yohandev/ezbot/src/assets/info/enclosure.png

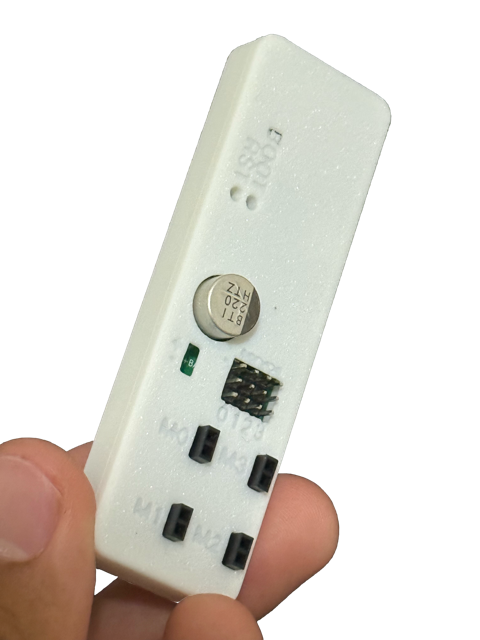
src/assets/info/enclosure.png
