yohandev/ezbot/src/assets/info/servo_motor.png

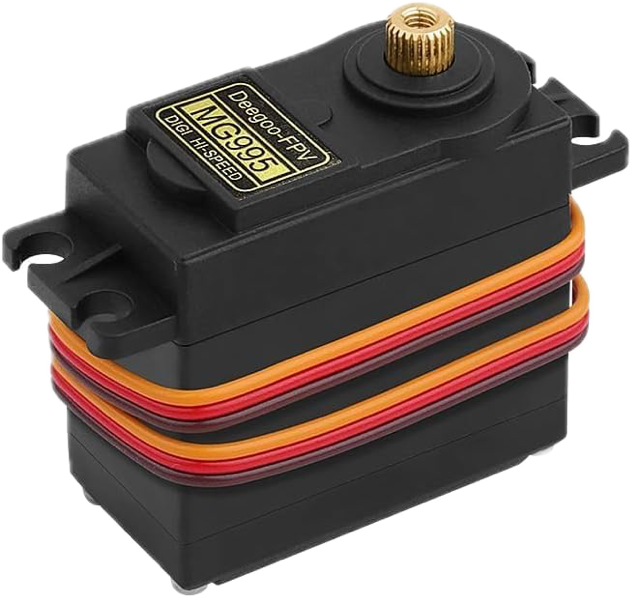
src/assets/info/servo_motor.png
