yohandev/ezbot/src/assets/bluefy.webp

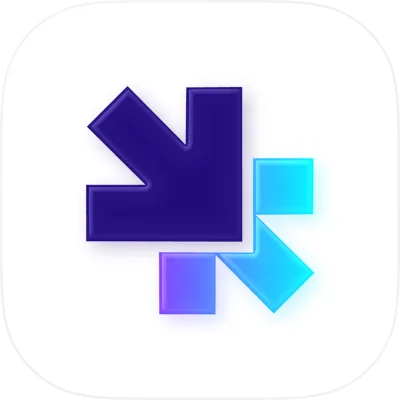
src/assets/bluefy.webp
