yohandev/ezbot/src/assets/info/battery.png

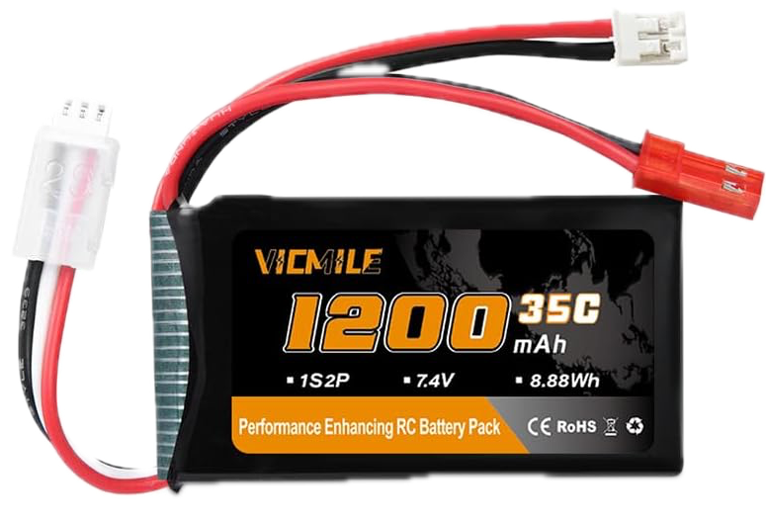
src/assets/info/battery.png
