yohandev/ezbot/src/assets/info/dc_motor.png

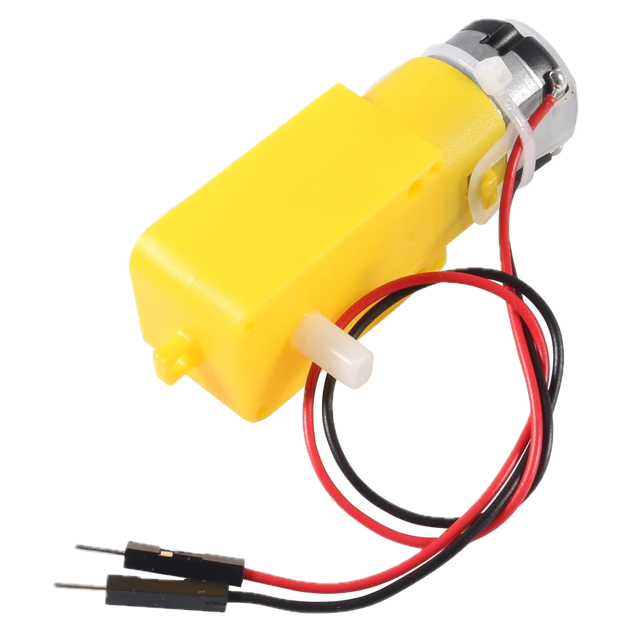
src/assets/info/dc_motor.png
