yohandev/ezbot/src/assets/demo-robot/chassis.3mf

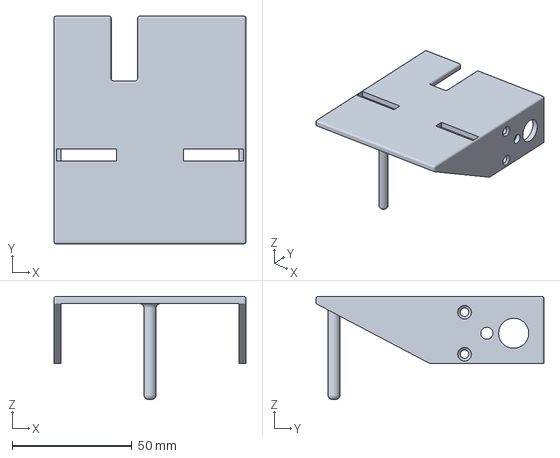
[picture p6: CAD file, 2026-04-05]
src/assets/demo-robot/chassis.3mf
80.0 x 95.0 x 43.0 mm
