yohandev/ezbot/src/assets/enclosure/lid.3mf

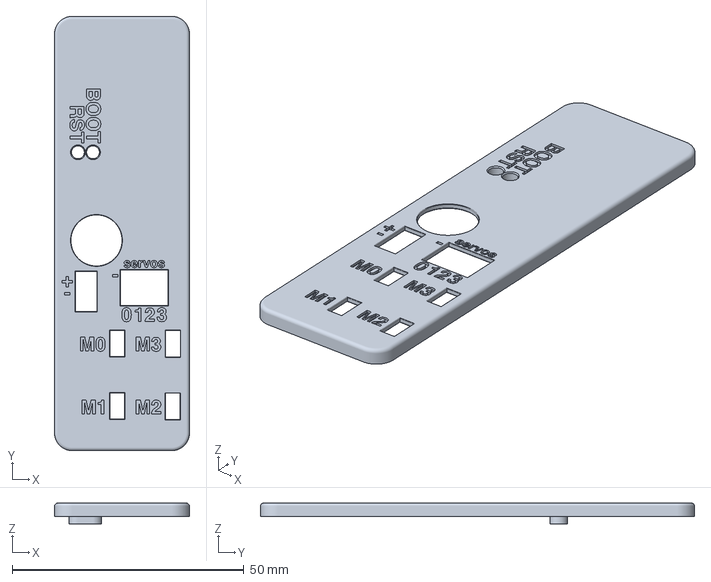
[picture p7: CAD file, 2026-04-09]
src/assets/enclosure/lid.3mf
29.1 x 93.6 x 4.50 mm
