yohandev/ezbot/src/assets/demo-robot/wheel.3mf

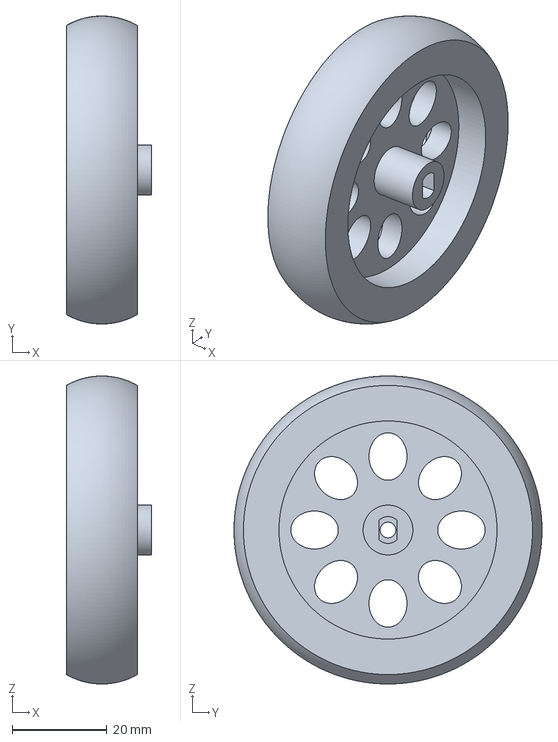
[picture p8: CAD file, 2026-04-05]
src/assets/demo-robot/wheel.3mf
18.0 x 65.0 x 65.0 mm
