yohandev/ezbot/src/assets/enclosure/body.3mf

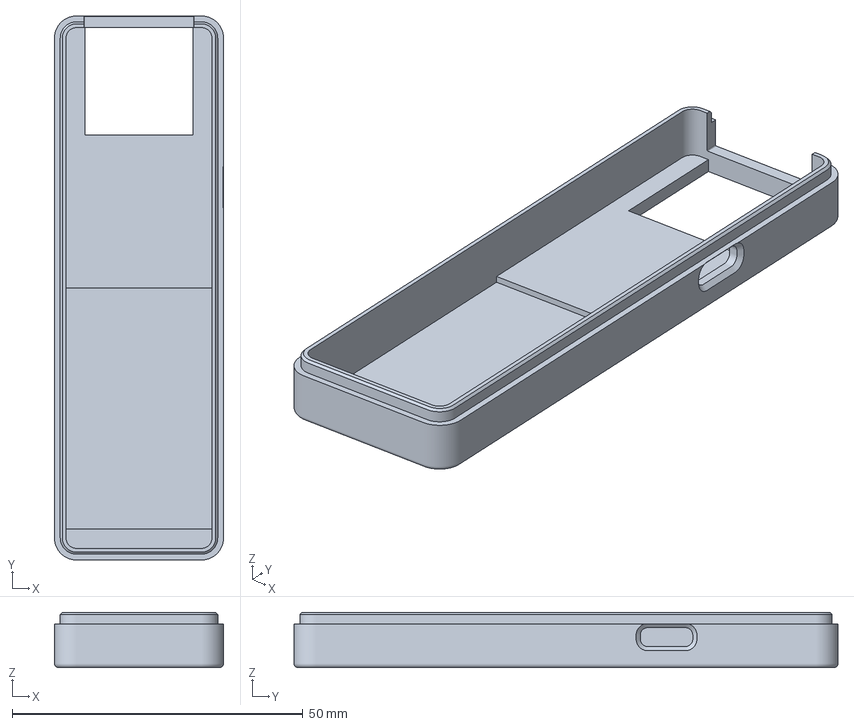
[picture p9: CAD file, 2026-04-09]
src/assets/enclosure/body.3mf
29.1 x 93.6 x 9.50 mm
