yohandev/ezbot/pcb/pcb.kicad_pcb

## KiCad design pcb/pcb.kicad_pcb (2026-04-09)

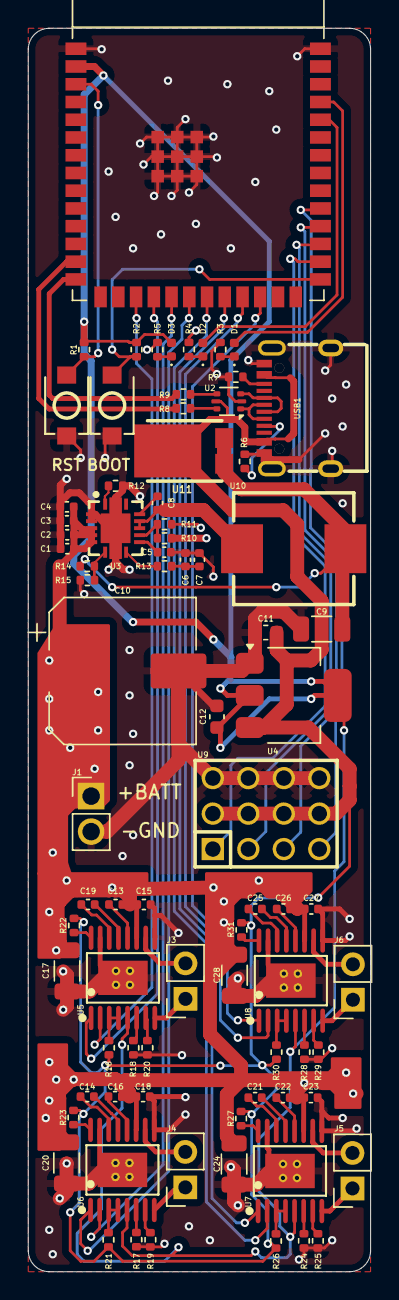
[picture p10: board pcb.kicad_pcb from above]

Board: 4 copper layers, 24.5 x 89.0 mm, 81 parts (0 on the bottom side), 76 nets.

Parts:
BOOT: TS-1088-AR02016; SW-SMD_L3.9-W3.0-P4.45
C1, C2, C3, C4: 4.7µF 1mΩ; C_0402_1005Metric
C5: 2.2nF 0Ω; C_0402_1005Metric
C6: 6.8nF; C_0402_1005Metric
C7: 68pF; C_0402_1005Metric
C8: 100nF; C_0402_1005Metric
C9: 47µF 3mΩ; C_1206_3216Metric
C10: 220µF; CP_Elec_10x10
C11, C12: 22µF 16V; C_0603_1608Metric
C13, C15, C16, C18, C22, C23, C26, C27: 0.1µF; C_0402_1005Metric
C14, C19, C21, C25: 0.022µF; C_0402_1005Metric
C17, C20, C24, C28: 100µF; C_1206_3216Metric
D1, D2, D3: LED; LED_0402_1005Metric
J1: Header Pins; PinHeader_1x02_P2.54mm_Vertical
J3, J4, J5, J6: Conn_01x02_Pin; PinSocket_1x02_P2.54mm_Vertical
R1, R2, R6, R7: 5kΩ; R_0402_1005Metric
R3, R4, R5: 1kΩ; R_0402_1005Metric
R8, R9: 0Ω; R_0402_1005Metric
R10: 102kΩ; R_0402_1005Metric
R11: 36.5kΩ; R_0402_1005Metric
R12, R14: 53.6kΩ; R_0402_1005Metric
R13: 3.92kΩ; R_0402_1005Metric
R15, R16, R21, R22, R23, R26, R27, R30, R31: 10kΩ; R_0402_1005Metric
R17, R18, R24, R28: 4.87kΩ; R_0402_1005Metric
R19, R20, R25, R29: 20kΩ; R_0402_1005Metric
RST: TS-1088-AR02016; SW-SMD_L3.9-W3.0-P4.45
U1: ESP32-S3-WROOM-1
U2: USBLC6-2P6; SOT-666
U3: TPS54620RHLR; VQFN-14_L3.5-W3.5-P0.50-TL-EP_TPS54622RHLT
U4: AMS1117-3.3; SOT-223-3_TabPin2
U5, U6, U7, U8: DRV8874PWPR; HTSSOP-16_L5.0-W4.4-P0.65-LS6.4-BL-EP
U9: 3x4; HDR-TH_12P-P2.54-V-M-R3-C4-S2.54
U10: 2.2µH 12.7mΩ; IND-SMD_L8.6-W8.0
U11: 10S45SP; TO-277_3P-L5.4-W4.0-LS6.5-TR-1
USB1: TYPE-C 16PIN 2MD(073); USB-C-SMD_TYPE-C-6PIN-2MD-073

Connections:
+3V3: C12.1, D3.2 (A), R1.1, R2.1, U1.2 (3V3), U4.2 (VO), U5.5 (VREF), U6.5 (VREF), U7.5 (VREF), U8.5 (VREF)
+5V: C11.1, R16.1, R21.1, R22.1, R23.1, R26.1, R27.1, R30.1, R31.1, U2.5 (VBUS), U4.3 (VI), U9.2, U9.5, U9.8, U9.11, U11.3 (K), USB1.2 (VBUS), USB1.11 (VBUS)
+BATT: C1.1, C2.1, C3.1, C4.1, C10.1, C13.2, C15.1, C16.2, C17.1, C18.1, C20.1, C22.2, C23.1, C24.1, C26.2, C27.1, C28.1, J1.1, R10.1, U3.4 (PVIN), U3.5 (PVIN), U3.6 (VIN), U5.11 (VM), U6.11 (VM), U7.11 (VM), U8.11 (VM)
BOOT: BOOT.2, R2.2, U1.27 (GPIO0/BOOT)
GND: BOOT.1, C1.2, C2.2, C3.2, C4.2, C5.2, C6.2, C7.2, C9.2, C10.2, C11.2, C12.2, C15.2, C17.2, C18.2, C20.2, C23.2, C24.2, C27.2, C28.2, J1.2, R3.2, R4.2, R5.2, R6.2, R7.2, R11.2, R12.2, R15.2, R17.2, R18.2, R19.2, R20.2, R24.2, R25.2, R28.2, R29.2, RST.1, U1.1 (GND), U1.40 (GND), U1.41 (GND), U2.2 (GND), U3.2 (GND), U3.3 (GND), U3.15 (EP), U4.1 (GND), U5.9 (PGND), U5.15 (GND), U5.17 (EP), U6.9 (PGND), U6.15 (GND), U6.17 (EP), U7.9 (PGND), U7.15 (GND), U7.17 (EP), U8.9 (PGND), U8.15 (GND), U8.17 (EP), U9.3, U9.6, U9.9, U9.12, USB1.1 (GND), USB1.12 (GND), USB1.13 (SHELL), USB1.14 (SHELL)
IO43: D1.2 (A), U1.37 (U0TXD/GPIO43/CLK_OUT1)
IO44: D2.2 (A), U1.36 (U0RXD/GPIO44/CLK_OUT2)
M0 EN: U1.18 (GPIO10/TOUCH10/ADC1_CH9/FSPICS0/FSPIIO4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), U5.1 (EN/IN1)
M0 PH: U1.17 (GPIO9/TOUCH9/ADC1_CH8/FSPIHD/SUBSPIHD), U5.2 (PH/IN2)
M1 EN: U1.20 (GPIO12/TOUCH12/ADC2_CH1/FSPICLK/FSPIIO6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), U6.1 (EN/IN1)
M1 PH: U1.19 (GPIO11/TOUCH11/ADC2_CH0/FSPID/FSPIIO5/S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), U6.2 (PH/IN2)
M2 EN: U1.22 (GPIO14/TOUCH14/ADC2_CH3/FSPIWP/FSPIDQS/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), U7.1 (EN/IN1)
M2 PH: U1.21 (GPIO13/TOUCH13/ADC2_CH2/FSPIQ/FSPIIO7/S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), U7.2 (PH/IN2)
M3 EN: U1.24 (GPIO47/SPICLK_P/SUBSPICLK_P_DIFF), U8.1 (EN/IN1)
M3 PH: U1.23 (GPIO21), U8.2 (PH/IN2)
unnamed: C6.1, C7.1, R13.2
unnamed: C8.1, U3.11 (PH), U3.12 (PH), U10.1
unnamed: C9.1, R14.1, U10.2, U11.1 (A), U11.2 (A)
unnamed: D1.1 (K), R3.1
unnamed: D2.1 (K), R4.1
unnamed: D3.1 (K), R5.1
unnamed: J3.1, U5.8 (OUT1)
unnamed: J3.2, U5.10 (OUT2)
unnamed: J4.1, U6.8 (OUT1)
unnamed: J4.2, U6.10 (OUT2)
unnamed: J5.1, U7.8 (OUT1)
unnamed: J5.2, U7.10 (OUT2)
unnamed: J6.1, U8.8 (OUT1)
unnamed: J6.2, U8.10 (OUT2)
unnamed: R8.1, U2.6 (I/O1)
unnamed: R9.1, U2.4 (I/O2)
unnamed: C8.2, U3.13 (BOOT)
unnamed: R13.1, U3.8 (COMP)
unnamed: R10.2, R11.1, U3.10 (EN)
unnamed: R12.1, U3.1 (RT/CLK)
unnamed: C5.1, U3.9 (SS/TR)
unnamed: R14.2, R15.1, U3.7 (VSENSE)
unnamed: C19.2, U5.13 (CPH)
unnamed: C19.1, U5.14 (CPL)
unnamed: R20.1, U5.7 (IMODE)
unnamed: R18.1, U5.6 (IPROPI)
unnamed: R22.2, U5.16 (PMODE)
unnamed: C13.1, U5.12 (VCP)
unnamed: R16.2, U5.3 (nSLEEP), U5.4 (nFAULT)
unnamed: C14.2, U6.13 (CPH)
unnamed: C14.1, U6.14 (CPL)
unnamed: R19.1, U6.7 (IMODE)
unnamed: R17.1, U6.6 (IPROPI)
unnamed: R23.2, U6.16 (PMODE)
unnamed: C16.1, U6.12 (VCP)
unnamed: R21.2, U6.3 (nSLEEP), U6.4 (nFAULT)
unnamed: C21.2, U7.13 (CPH)
unnamed: C21.1, U7.14 (CPL)
unnamed: R25.1, U7.7 (IMODE)
unnamed: R24.1, U7.6 (IPROPI)
unnamed: R27.2, U7.16 (PMODE)
unnamed: C22.1, U7.12 (VCP)
unnamed: R26.2, U7.3 (nSLEEP), U7.4 (nFAULT)
unnamed: C25.2, U8.13 (CPH)
unnamed: C25.1, U8.14 (CPL)
unnamed: R29.1, U8.7 (IMODE)
unnamed: R28.1, U8.6 (IPROPI)
unnamed: R31.2, U8.16 (PMODE)
unnamed: C26.1, U8.12 (VCP)
unnamed: R30.2, U8.3 (nSLEEP), U8.4 (nFAULT)
unnamed: R6.1, USB1.4 (CC1)
unnamed: R7.1, USB1.10 (CC2)
unnamed: U2.1 (I/O1), USB1.5 (DN2), USB1.7 (DN1)
unnamed: U2.3 (I/O2), USB1.6 (DP1), USB1.8 (DP2)
RST: R1.2, RST.2, U1.3 (EN)
S0: U1.28 (SPIIO6/GPIO35/FSPID/SUBSPID), U9.1
S1: U1.29 (SPIIO7/GPIO36/FSPICLK/SUBSPICLK), U9.4
S2: U1.30 (SPIDQS/GPIO37/FSPIQ/SUBSPIQ), U9.7
S3: U1.31 (GPIO38/FSPIWP/SUBSPIWP), U9.10
USB D+: R9.2, U1.14 (GPIO20/U1CTS/ADC2_CH9/CLK_OUT1/USB_D+)
USB D-: R8.2, U1.13 (GPIO19/U1RTS/ADC2_CH8/CLK_OUT2/USB_D-)
