yohandev/ezbot/src/upload/info.js

import heroVideo from "../assets/info/hero.mp4";
import pcbInstructions from "../assets/info/pcb_instructions.mp4";
import batteryImg from "../assets/info/battery.png";
import dcMotorImg from "../assets/info/dc_motor.png";
import servoMotorImg from "../assets/info/servo_motor.png";
import enclosureImg from "../assets/info/enclosure.png";

const abs = (path) => new URL(path, import.meta.url).href;

document.getElementById("info-video-hero-src").src = abs(heroVideo);
document.getElementById("info-video-hero").load();

document.getElementById("info-video-pcb-src").src = abs(pcbInstructions);
document.getElementById("info-video-pcb").load();

document.getElementById("info-img-battery").src = abs(batteryImg);
document.getElementById("info-img-dc-motors").src = abs(dcMotorImg);
document.getElementById("info-img-servo-motors").src = abs(servoMotorImg);
document.getElementById("info-img-enclosure").src = abs(enclosureImg);
