yohandev/ezbot/(commit log)

2026-04-04 Fix firmware bricked in Thonny
    [main.py, remote.py]
2026-04-04 Fix motor driver
2026-04-04 Fix reconnection (when remote disconnects)
    [remote.py]
2026-04-05 Add demo bot
    [chassis.3mf, wheel.3mf]
2026-04-07 Add servo
2026-04-08 Fix remote name not being advertised
    [remote.py]
2026-04-09 Add enclosure
    [body.3mf, lid.3mf]
2026-04-09 Add PCB
    [motor_driver.kicad_sch, pcb.kicad_pcb, pcb.kicad_sch, power_system.kicad_sch]
2026-04-09 Add clarification on servo motor
2026-04-09 Fix images when deployed
    [info.js]
